jordanstark/Soil_temp_moisture_EMU/Construction/BoM_EMU_v2_JS.xlsx

Stark-Htet EMU B version Bill of Materials
Item | Cost | Supplier
LOLIN D1 mini V3.1.0 - WEMOS WIFI ESP8266 board | $3.50 | AliExpress
DS3231 RTC module | $0.98 | AliExpress
Battery holder, 4 x AAA long, no switch | $0.33 | AliExpress
P channel MOSFET: IRF9640, Vishay | $1.09 | Mouser
Soil moisture sensor (resistance probe) x 2 | $1.32 | AliExpress
Custom circuit board | $0.37 | JLCPCB (100 pc order)
ADS1115 ADC | $1.40 | AliExpress
CR 2032 cell coin batteries (for RTC) | $0.17 | AliExpress
4 AAA batts (Duracell) | $2.36 | Amazon
DS18B20 digital temperature sensor | $1.25 | AliExpress
Resistors (2) | $0.12 | Amazon
Heat shrink tube, solder, PVC primer and cement, PTFE tape | $1.00 | misc
PVC 2" screw on cap | $2.17 | Grainger
PVC 2" MNPT x Socket adapter | $1.23 | Grainger
PVC 2" reducing bushing spigot by FNTP 2" x 1/2" | $1.93 | Grainger
PG 13.5 cable gland | $0.28 | AliExpress
2.54 mm jumper | $0.06 | Amazon
24 AWG 2 strand wire | $0.50 | Amazon
TOTAL | $20.06
