jordanstark/Soil_temp_moisture_EMU/Csensor_read_dl/Csensor_read_dl.ino

// Code to write data from sensors to SPIFFS memory in dataloggers
// For Oct 2019 trip to GSMNP


#include <Wire.h>

#include <Adafruit_ADS1015.h>     //Adafruit ADS1115 library-this controls the analog to digital converter      
  Adafruit_ADS1115 ads1115(0x48);     // sets I2C address for the ADC    

#include "FS.h"                   //File system library for SPIFFS

#include "uRTCLib.h"              //Library to run the RTC alarm -- there are other libraries available but this seemed most straightforward for just setting the alarm
#define URTCLIB_MODEL_DS3231 2        //RTC model
uRTCLib rtc(0x68);                    //RTC I2C address

#include <OneWire.h>              
#include <DallasTemperature.h>    //Both of these libraries are for the soil temp sensor
#define ONE_WIRE_BUS 2                // DS18B20 does not use I2C, runs on OneWire protocol
OneWire oneWire(ONE_WIRE_BUS);        //Initializes the OneWire protocol
DallasTemperature temps(&oneWire);

void setup() {
  Serial.begin(9600);
  SPIFFS.begin();
  Wire.begin();
  digitalWrite( SDA, LOW);      //This may not be necessary but could recover I2C if shut down incorrectly
  digitalWrite( SCL, LOW);

  //ds3231 clock
    rtc.set_model(URTCLIB_MODEL_DS3231);
    rtc.set_rtc_address(0x68);
    rtc.alarmSet(URTCLIB_ALARM_TYPE_1_FIXED_MS, 0, 0, 0, 1); // this sets the alarm to turn the system on and run code every hour on the hour
        // other alarm types are  URTCLIB_ALARM_TYPE_1_ALL_S - Every second
                                //URTCLIB_ALARM_TYPE_1_FIXED_S - Every minute at given second
                                //URTCLIB_ALARM_TYPE_1_FIXED_MS - Every hour at given Minute:Second
                                //URTCLIB_ALARM_TYPE_1_FIXED_HMS - Every day at given Hour:Minute:Second
                                //URTCLIB_ALARM_TYPE_1_FIXED_DHMS - Every month at given DAY-Hour:Minute:Second
                                //URTCLIB_ALARM_TYPE_1_FIXED_WHMS - Every week at given DOW + Hour:Minute:Second
                                //URTCLIB_ALARM_TYPE_2_ALL_M - Every minute at 00 Seconds
                                //URTCLIB_ALARM_TYPE_2_FIXED_M - Every hour at given Minute(:00)
                                //URTCLIB_ALARM_TYPE_2_FIXED_HM - Every day at given Hour:Minute(:00)
                                //URTCLIB_ALARM_TYPE_2_FIXED_DHM - Every month at given DAY-Hour:Minute(:00)
                                //URTCLIB_ALARM_TYPE_2_FIXED_WHM - Every week at given DOW + Hour:Minute(:00)
        // for _FIXED_ alarms, the integers set the time of the alarm -- second, minute, hour, dayofweek
            //so for an alarm every hour at :30, (URTCLIB_ALARM_TYPE_1_FIXED_MS, 0, 30, 0, 1)
        // the library uses 1 as default for dayofweek so I haven't changed that but it doesn't affect most alarms
        // should be possible to alternate alarms 1 and 2 for more intervals but I haven't gotten that working

  //ads1115 analog to digital converter for vmc
    ads1115.begin();    
    ads1115.setGain(GAIN_ONE); //set gain on the ADC
 
  //OneWire for soil temp probe
    temps.begin();

  //Initialize SPIFFS
  File f = SPIFFS.open("/data.csv", "a"); // open SPIFFS file in annotate mode to add one line of data at the end

  
  // collect sensor data
      rtc.refresh(); //update time from the rtc
   
      int y  = rtc.year();
      int mo = rtc.month();
      int d  = rtc.day();
      int h  = rtc.hour();
      int m  = rtc.minute();
      
      int raw_vmc_2 = ads1115.readADC_SingleEnded(2); // deep sensor (short cable)
      int raw_vmc_3 = ads1115.readADC_SingleEnded(3); // shallow sensor (long cable
      
      
      temps.requestTemperatures();
      temps.getTempCByIndex(0); //read the soil temperature
      
      delay(800); // lux and soil temp both require delay after first read before reading accurately
                  // 500 is enough for lux but not soil temp; 750 gives some ok readings but not all

      // these readings are what are actually written to file
      float soiltemp = temps.getTempCByIndex(0);  // soil temp

      int power = analogRead(A0); //this reads the 5V line through the resistor to A0

  // write sensor data to file
      f.print(y);
      f.print(",");
      f.print(mo);
      f.print(",");
      f.print(d);
      f.print(",");
      f.print(h);
      f.print(",");
      f.print(m);
      f.print(",");
      f.print(raw_vmc_2);
      f.print(",");
      f.print(raw_vmc_3);
      f.print(",");
      f.print(soiltemp);
      f.print(",");
      f.print(power);
      f.print(",");
      f.print("C20");     // EDIT FOR EACH SENSOR
      f.println();
  
  // close file
      f.close();        // Data is not actually written to file until this runs

  // reset clock flag to turn power off
      rtc.alarmClearFlag(URTCLIB_ALARM_1);

  // if the alarm doesn't work to turn off    
  
  f = SPIFFS.open("/data.csv", "a");
  f.println("err1");
  f.close();                                    // Err1 = ESP did not turn off after clearing the alarm flag. 
                                                    //This will appear once in data when ESP is plugged in because it cannot power off
  
  if(!Serial) {
    ESP.deepSleep(60e6); //this can be used instead of ESP.restart if D0 is connected to rst
    ESP.restart();
  }

}


void loop() {

  File f = SPIFFS.open("/data.csv", "a");
  f.println("loop1");
  f.close();

  // download data if connected to computer

  if(Serial) {
    File f = SPIFFS.open("/data.csv", "a");  //open in annotate mode to see how long it is - file name must match exactly
    if (!f) {
        Serial.println("file open failed");
      }  Serial.println("====== read length =======");
  
  

    f.println("loop2");
    float len = f.position(); //this determines the number of bytes in the file
    Serial.print(len);
  
    f.close();
  
    delay(2000);
  
    // open file for reading
    f = SPIFFS.open("/data.csv", "r"); //open file in read mode to print the data to the serial monitor
    if (!f) {
          Serial.println("file open failed");
      }  
    
    Serial.println("====== Reading from SPIFFS file =======");
    // read file
  
    for (int i=1; i<=len; i++){ 
      //this currently will keep printing a huge number of lines to the serial output
      //if you know how many bytes each line will be, change line above to read ... ; i<=len/[bytesperline];i++ ...
      //alternatively, just close the puTTY connection after it has stopped reading in data
      String s=f.readStringUntil('\n'); //reads the first line of the file
      Serial.print(i);
      Serial.print(":"); // if line numbers are not needed, comment out this line and the line above 
      Serial.println(s);
    }
  }
  
  ESP.restart();

}
