jordanstark/Soil_temp_moisture_EMU/(commit log)

2021-04-26 code for running, calibrating and processing field sensors
    [data.csv]
2021-05-05 Initial process for cleaning sensor data
2021-05-10 updated process for identifying broken sensors
2021-06-03 updated A sensor code
    [data.csv]
2021-08-12 Updated to remove sensors with errors that don't end
2021-10-15 added calib_coefs.csv
    [calib_coefs.csv]
2021-10-23 Added construction protocols and bill of materials
    [BoM_EMU_v2_JS.xlsx]
